OperationSmallKat/Luna-CAD/README.md

# Luna-CAD

Config file for CR6 should be placed in

```
$HOME/.local/share/cura-lulzbot/3.2/definition_changes/Creality+CR-6_settings.inst.cfg
```

derrived from https://community.ultimaker.com/topic/33852-creality-cr6-se/

and the .curaprofile imported through the GUI
