OperationSmallKat/Luna-CAD/Final Production Model/3D printing/Bed1Color1 (CR-6 SE).3mf

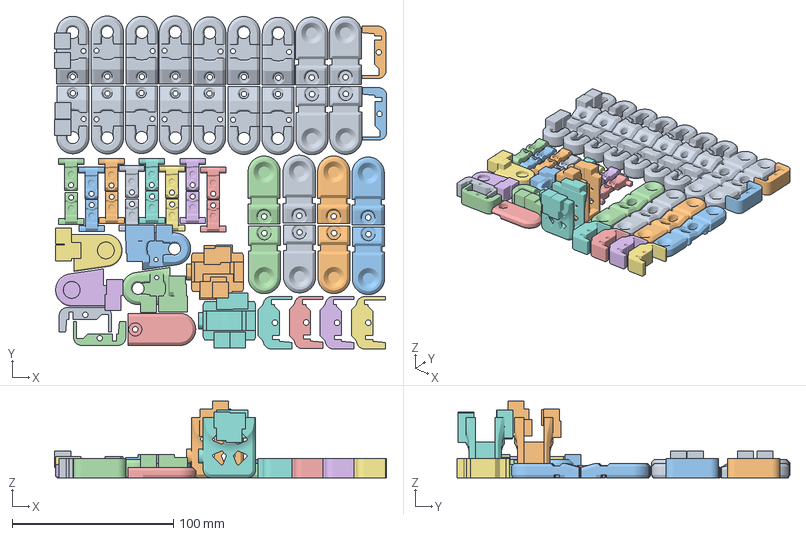
[picture p1: CAD file, 2021-01-08]
Final Production Model/3D printing/Bed1Color1 (CR-6 SE).3mf
206.0 x 206.4 x 47.5 mm
Group #4
Group #5
Group #6
Group #9
Servo Limb 4.stl
Group #8
Group #17
Shoulder Servo Cover.stl
Body Servo Cover.stl
Body Servo Cover.stl(1)
Body Servo Cover.stl(2)
Body Servo Cover.stl(3)
Shoulder Servo Cover.stl(1)
Shoulder Servo Cover.stl(2)
Shoulder Servo Cover.stl(3)
Group #18
Group #1
Group #19
Group #3
Group #16
Servo Limb 1 pt2.stl(8)
Servo Limb 1 pt2 (Mirror).stl
Servo Limb 1 pt2.stl(1)
Servo Limb 1 pt2 (Mirror).stl(2)
Servo Limb 1 pt2.stl(3)
Servo Limb 1 pt2.stl(4)
Servo Limb 1 pt2.stl(5)
Servo Limb 1 pt2 (Mirror).stl(6)
Servo Limb pt2 (Mirror).stl
Servo Limb pt2 (Mirror).stl(1)
Servo Limb pt2 (Mirror).stl(2)
Servo Limb pt2 (Mirror).stl(3)
Servo Limb pt2 (Mirror).stl(4)
Servo Limb pt2 (Mirror).stl(5)
Servo Limb pt2 (Mirror).stl(6)
Servo Limb pt2 (Mirror).stl(7)
