OperationSmallKat/Luna-CAD/Final Production Model/Body.stl

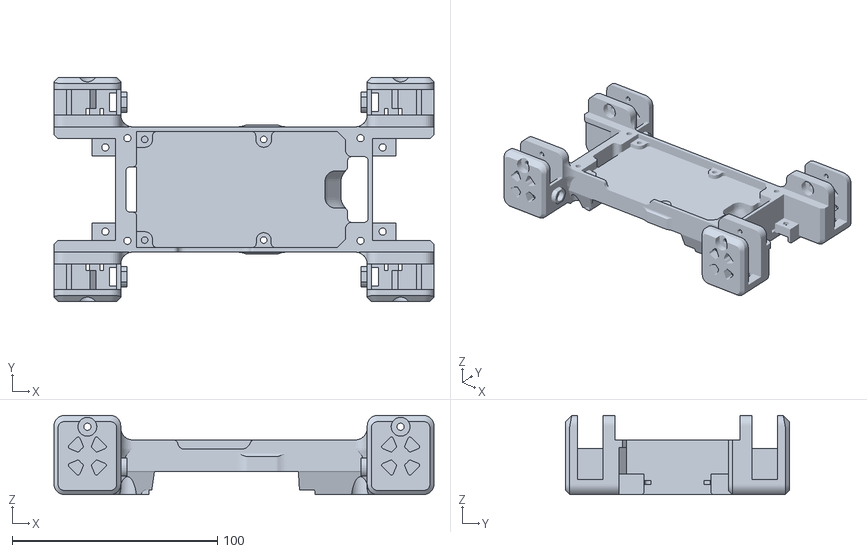
[picture p2: CAD file, 2021-04-23]
Final Production Model/Body.stl
185.0 x 109.0 x 38.5
