OperationSmallKat/Luna-CAD/Final Production Model/3D printing/Bed3Color2 (CR-6 SE).3mf

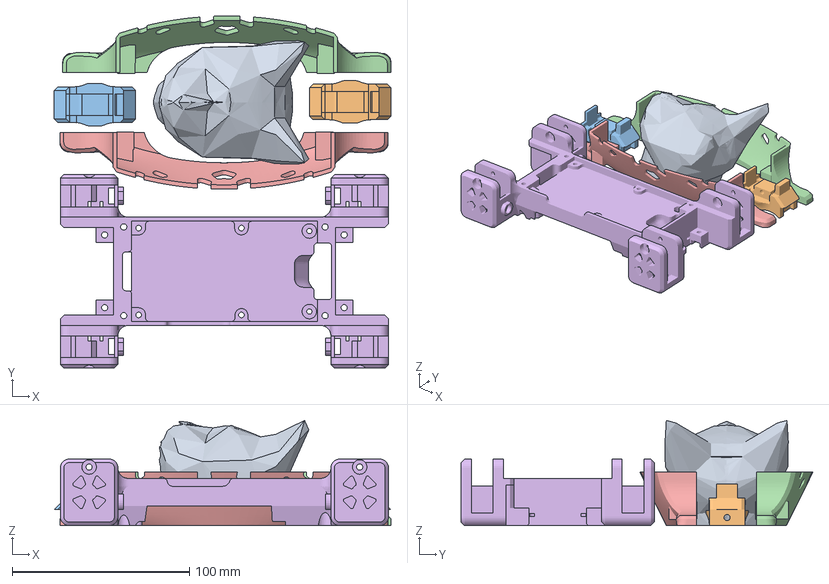
[picture p3: CAD file, 2021-01-08]
Final Production Model/3D printing/Bed3Color2 (CR-6 SE).3mf
189.9 x 198.4 x 59.3 mm
Head.stl
Knee Base.stl
Knee Base.stl(1)
Group #1
Group #2
Body.stl
