OperationSmallKat/Luna-CAD/Final Production Model/Foot-Joystick-Model.stl

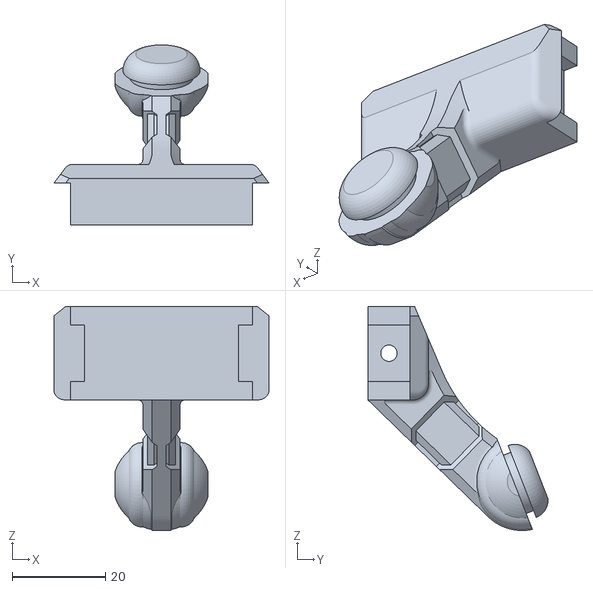
[picture p4: CAD file, 2021-02-12]
Final Production Model/Foot-Joystick-Model.stl
46.0 x 38.6 x 47.9
