OperationSmallKat/Luna-CAD/Final Production Model/Tests/Servo Limb 1 v7 pt2.stl

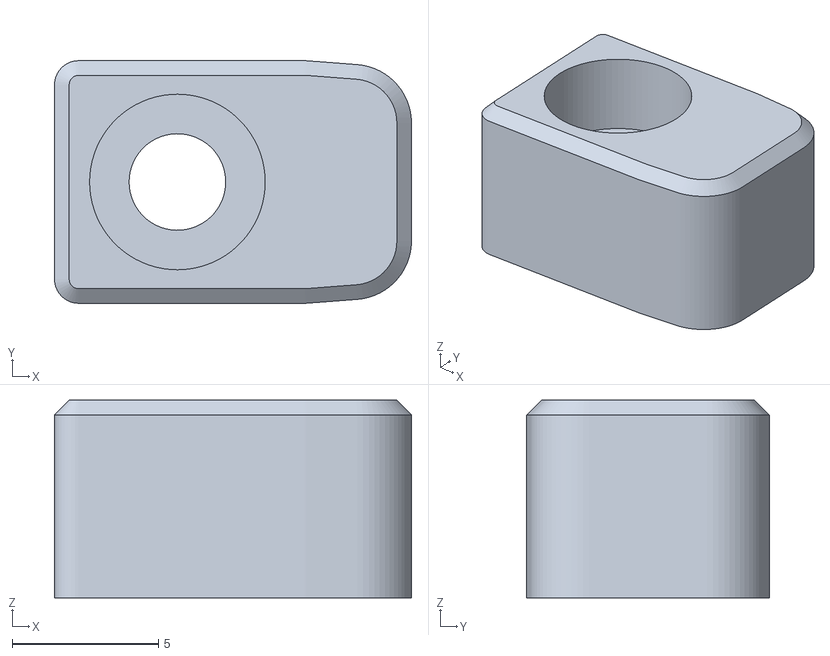
[picture p5: CAD file, 2021-02-20]
Final Production Model/Tests/Servo Limb 1 v7 pt2.stl
12.2 x 8.29 x 6.75
