OperationSmallKat/Luna-CAD/Final Production Model/Servo Limb pt2 (Mirror).stl

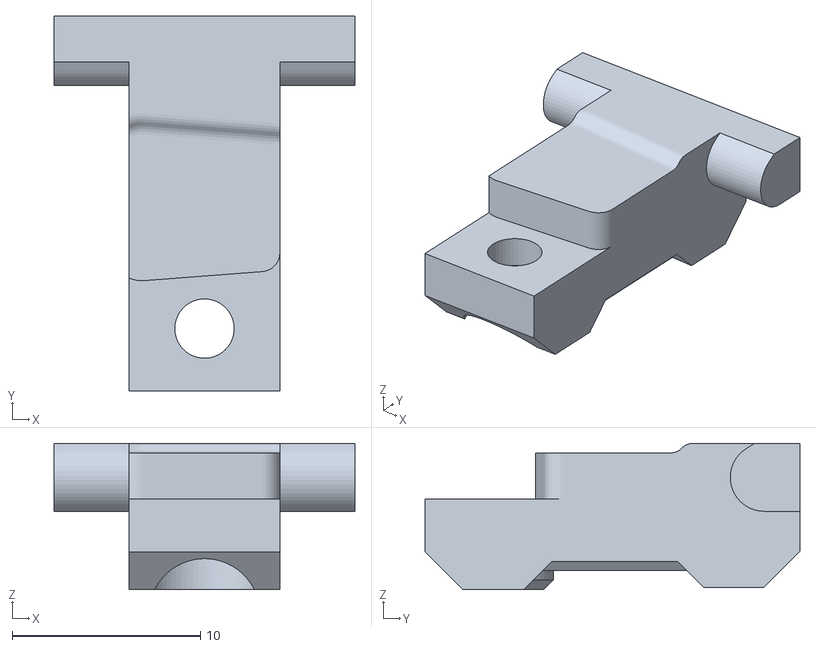
[picture p6: CAD file, 2021-01-08]
Final Production Model/Servo Limb pt2 (Mirror).stl
16.0 x 19.9 x 7.75
