OperationSmallKat/Luna-CAD/Final Production Model/Tests/Servo Limb 1 v7.stl

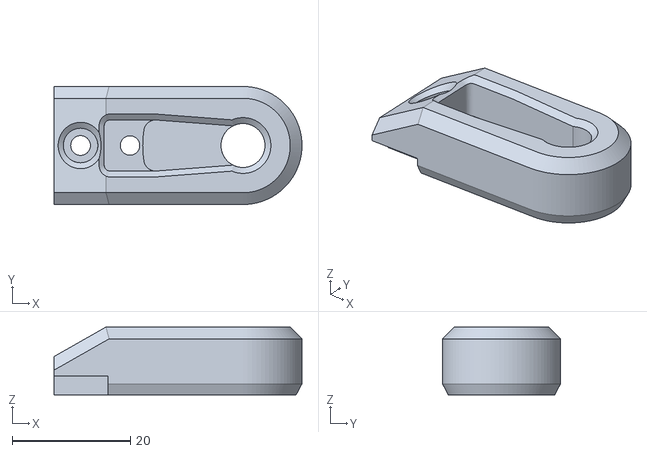
[picture p7: CAD file, 2021-02-20]
Final Production Model/Tests/Servo Limb 1 v7.stl
42.0 x 20.0 x 11.5
