OperationSmallKat/Luna-CAD/Final Production Model/3D printing/Bed2Color2 (CR-6 SE).3mf

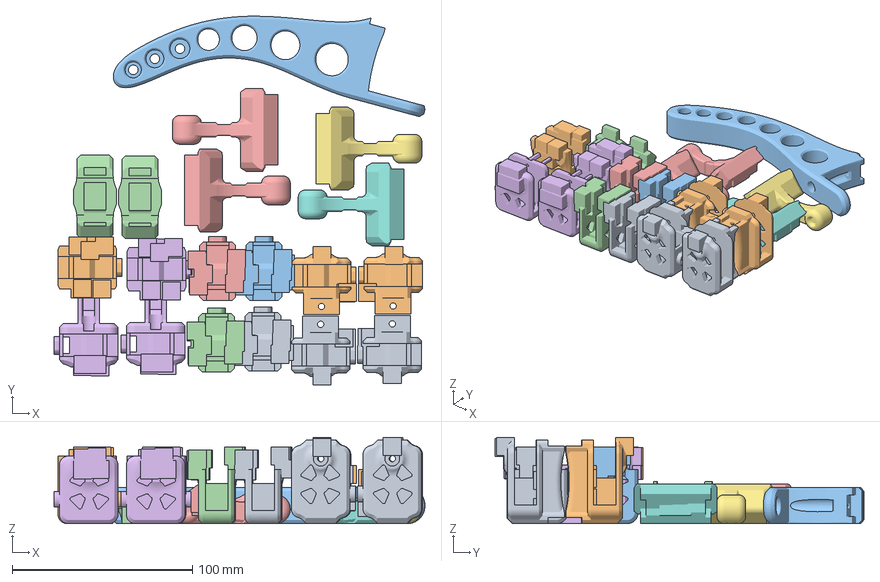
[picture p8: CAD file, 2020-12-29]
Final Production Model/3D printing/Bed2Color2 (CR-6 SE).3mf
205.8 x 204.5 x 47.8 mm
Group #6
Group #7
Group #8
Group #9
Group #10
Group #12
Foot.stl(3)
Foot.stl
Group #1
Group #2
Tail.stl
Group #4
Group #3
Group #5
