OperationSmallKat/Luna-CAD/Final Production Model/Calibration Jig.stl

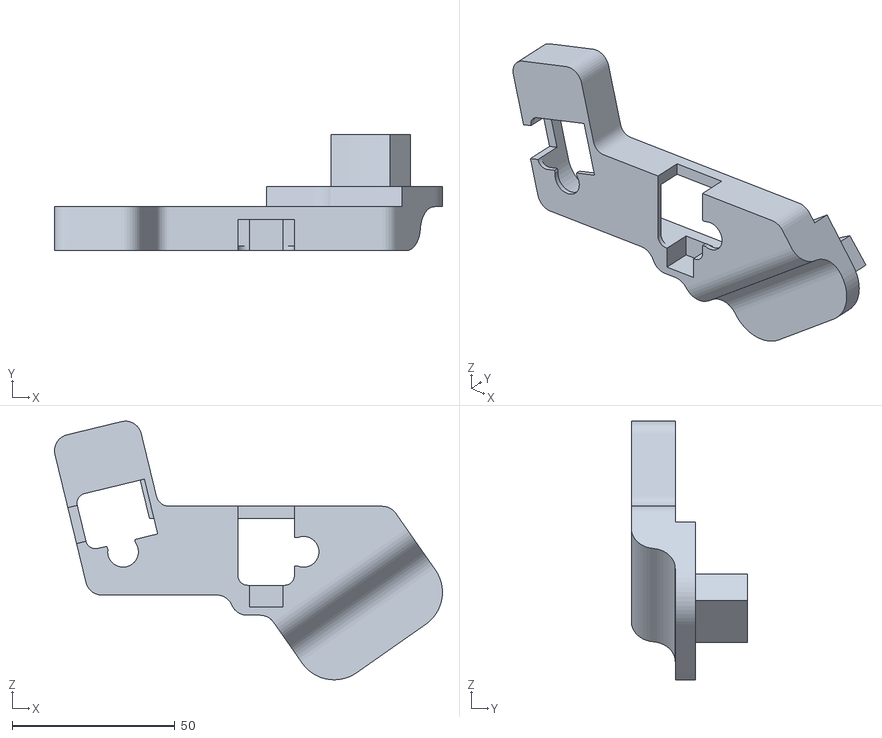
[picture p9: CAD file, 2021-01-03]
Final Production Model/Calibration Jig.stl
119.3 x 35.7 x 79.5
