OperationSmallKat/Luna-CAD/Final Production Model/Servo Limb 3.stl

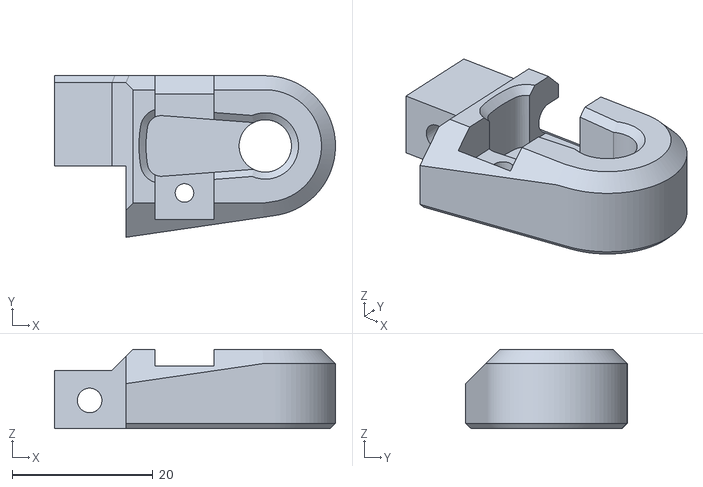
[picture p10: CAD file, 2020-12-31]
Final Production Model/Servo Limb 3.stl
40.0 x 23.0 x 11.2
