OperationSmallKat/Luna-CAD/Final Production Model/Servo Limb 1 - Small Horn.stl

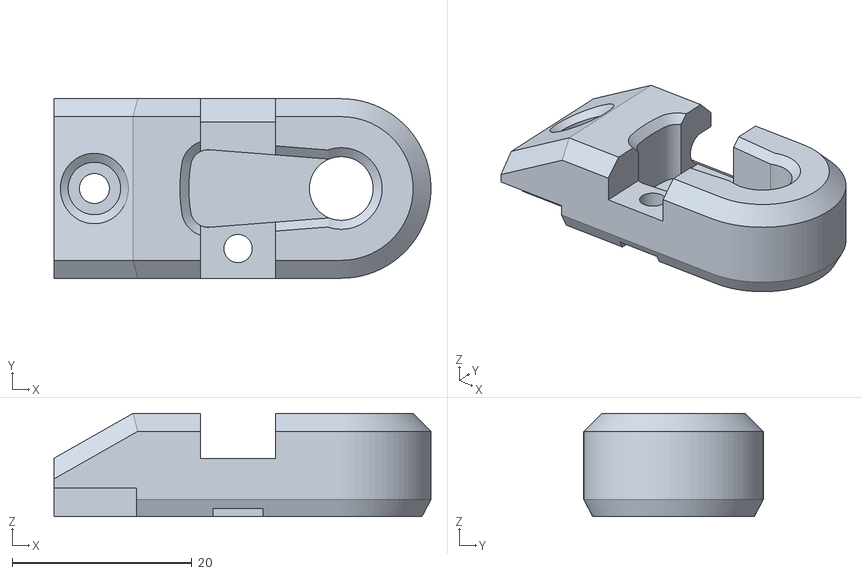
[picture p11: CAD file, 2020-12-27]
Final Production Model/Servo Limb 1 - Small Horn.stl
42.0 x 20.0 x 11.5
