OperationSmallKat/Luna-CAD/Final Production Model/Body Servo Cover.stl

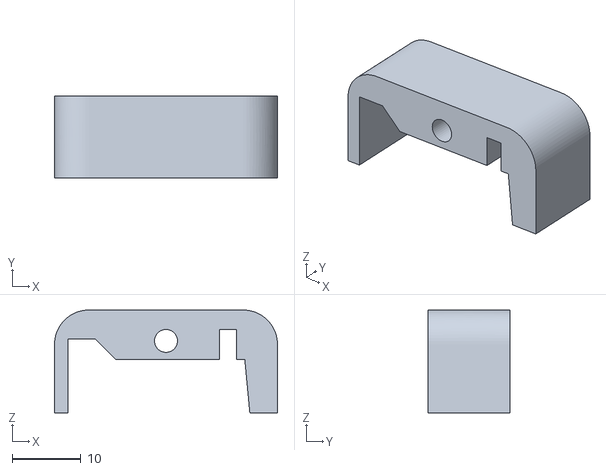
[picture p12: CAD file, 2020-12-19]
Final Production Model/Body Servo Cover.stl
32.5 x 12.0 x 15.0
