OperationSmallKat/Luna-CAD/Final Production Model/Shoulder Base (Mirror).stl

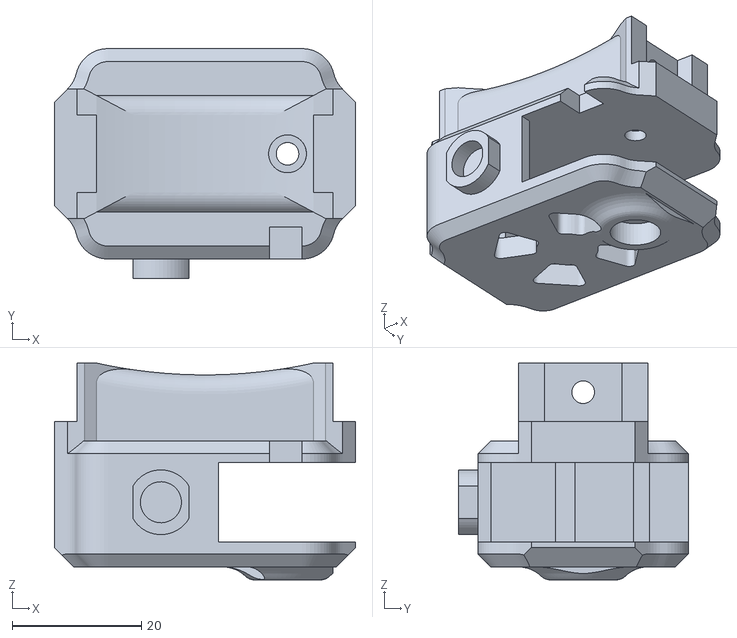
[picture p13: CAD file, 2020-12-19]
Final Production Model/Shoulder Base (Mirror).stl
46.5 x 35.5 x 33.5
