OperationSmallKat/Luna-CAD/Final Production Model/Servo Limb 5.stl

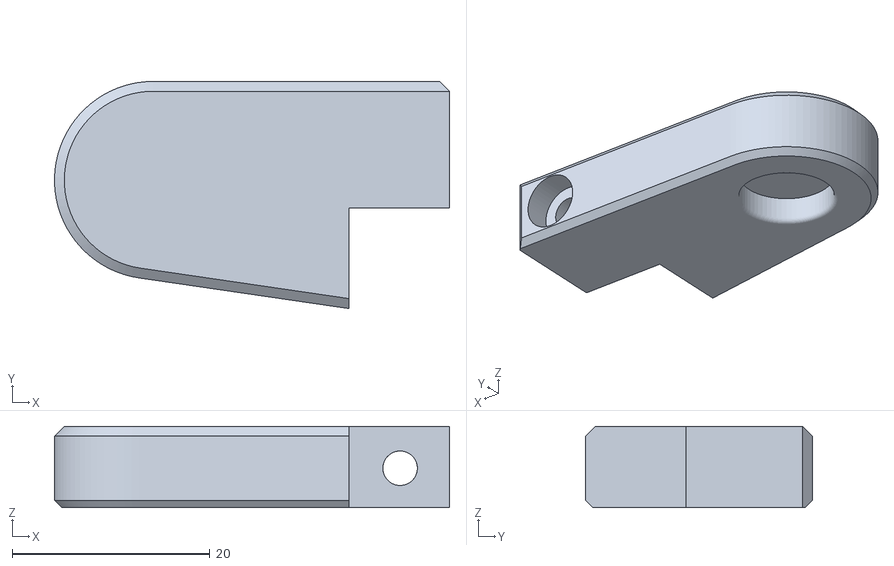
[picture p14: CAD file, 2020-12-19]
Final Production Model/Servo Limb 5.stl
40.0 x 23.0 x 8.25
