OperationSmallKat/Luna-CAD/Final Production Model/Head and Tail Base.stl

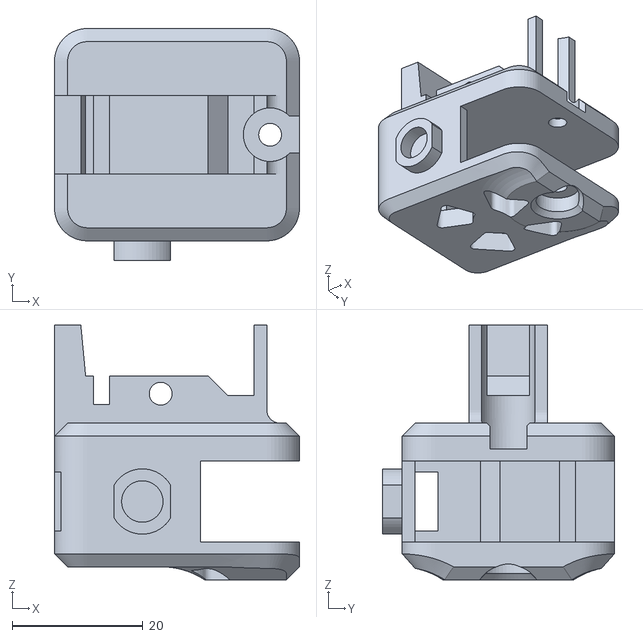
[picture p15: CAD file, 2020-12-19]
Final Production Model/Head and Tail Base.stl
37.5 x 35.5 x 39.0
