OperationSmallKat/Luna-CAD/Final Production Model/Head and Tail Servo Cover.stl

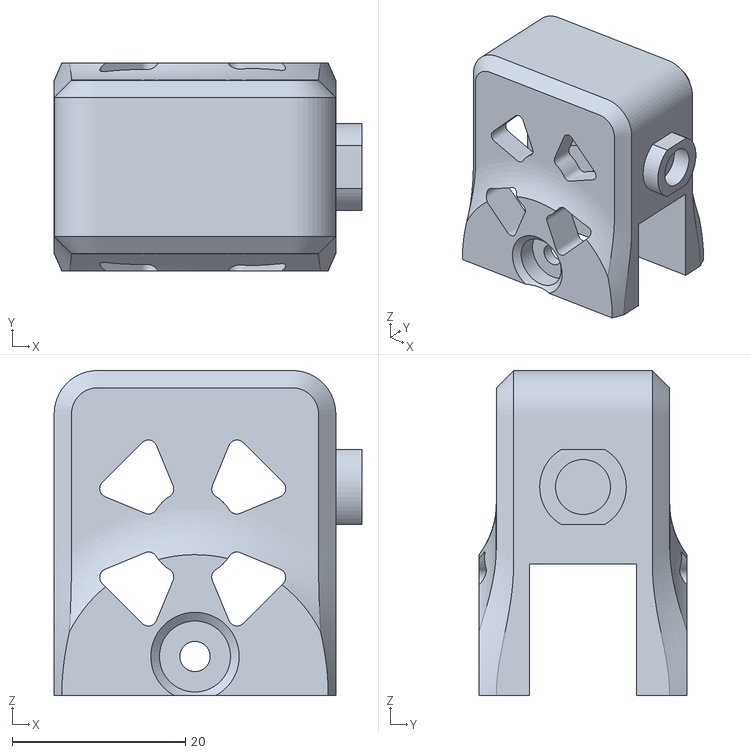
[picture p16: CAD file, 2020-12-19]
Final Production Model/Head and Tail Servo Cover.stl
35.5 x 24.0 x 37.5
