OperationSmallKat/Luna-CAD/Final Production Model/Shoulder Servo Cover.stl

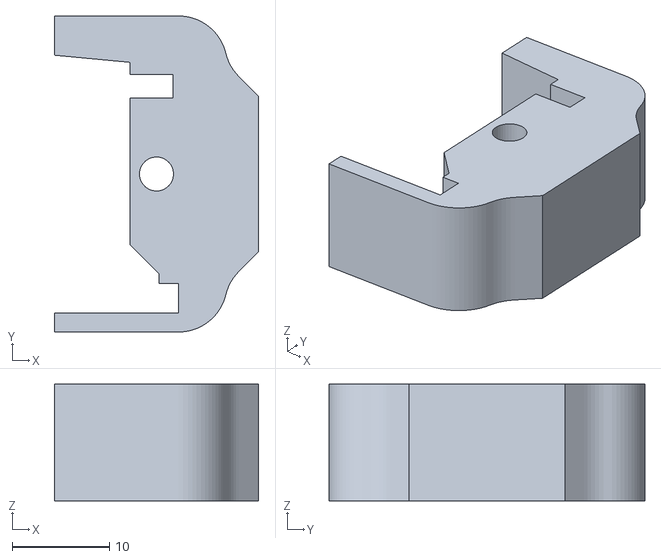
[picture p17: CAD file, 2020-12-19]
Final Production Model/Shoulder Servo Cover.stl
21.0 x 32.5 x 12.0
