OperationSmallKat/Luna-CAD/Final Production Model/Knee Top.stl

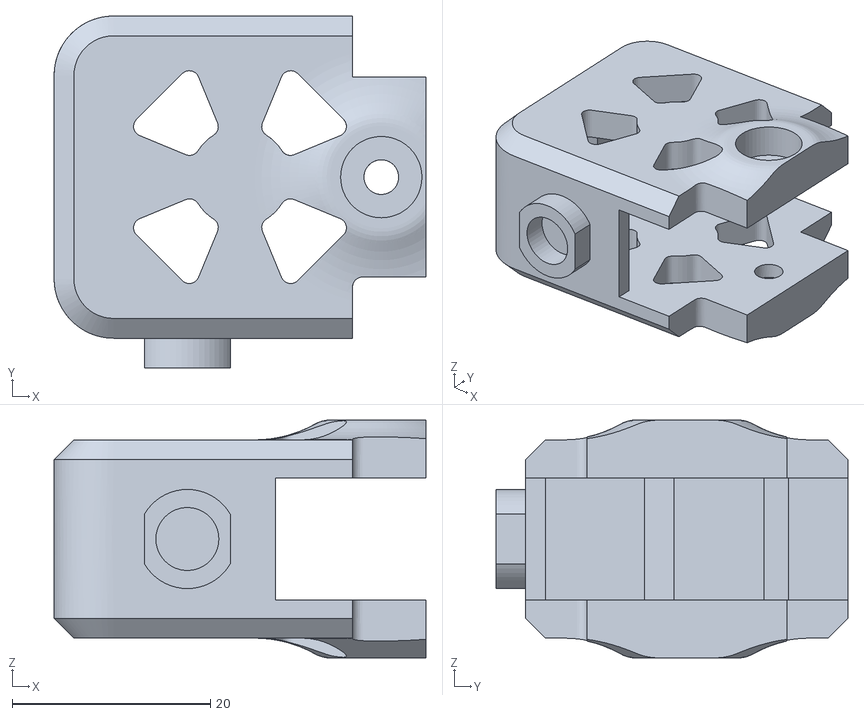
[picture p18: CAD file, 2020-12-19]
Final Production Model/Knee Top.stl
37.5 x 35.5 x 24.0
