OperationSmallKat/Luna-CAD/Final Production Model/Servo Limb 6 (Backup).stl

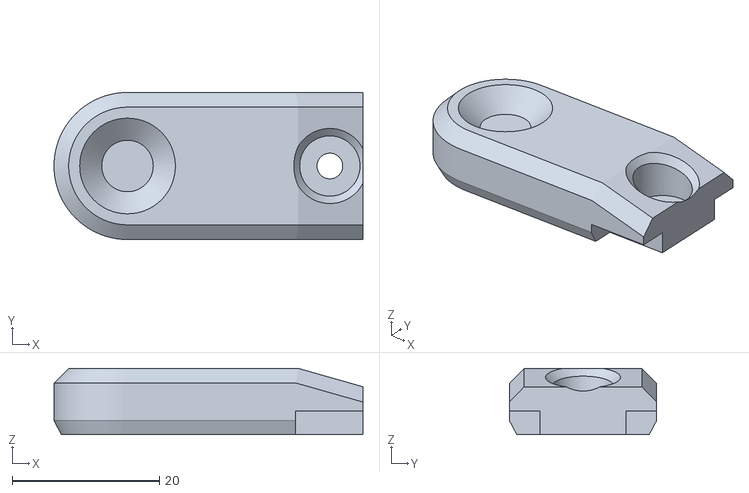
[picture p19: CAD file, 2020-12-19]
Final Production Model/Servo Limb 6 (Backup).stl
42.0 x 20.0 x 9.00
