OperationSmallKat/Luna-CAD/Final Production Model/Body Cover.stl

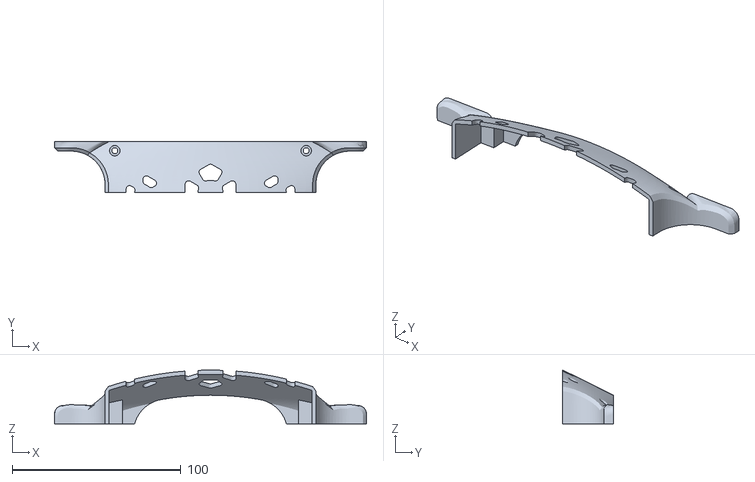
[picture p20: CAD file, 2020-12-19]
Final Production Model/Body Cover.stl
185.0 x 30.3 x 31.9
