OperationSmallKat/Luna-CAD/Final Production Model/Servo Limb 2.stl

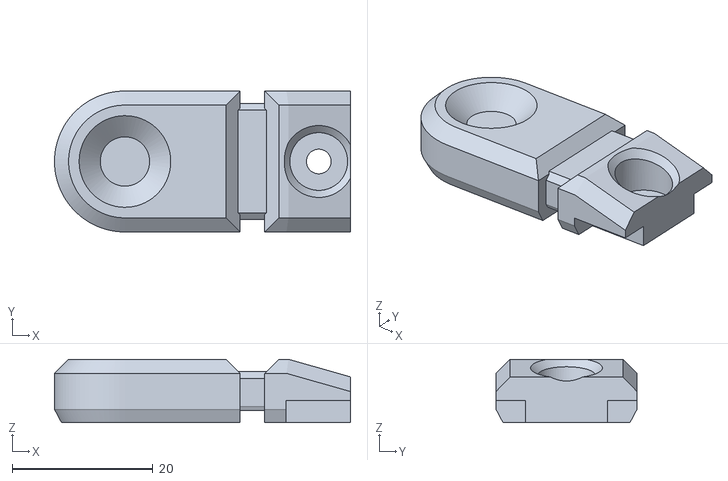
[picture p21: CAD file, 2020-12-19]
Final Production Model/Servo Limb 2.stl
42.0 x 20.0 x 9.00
