OperationSmallKat/Luna-CAD/Final Production Model/Servo Limb 4.stl

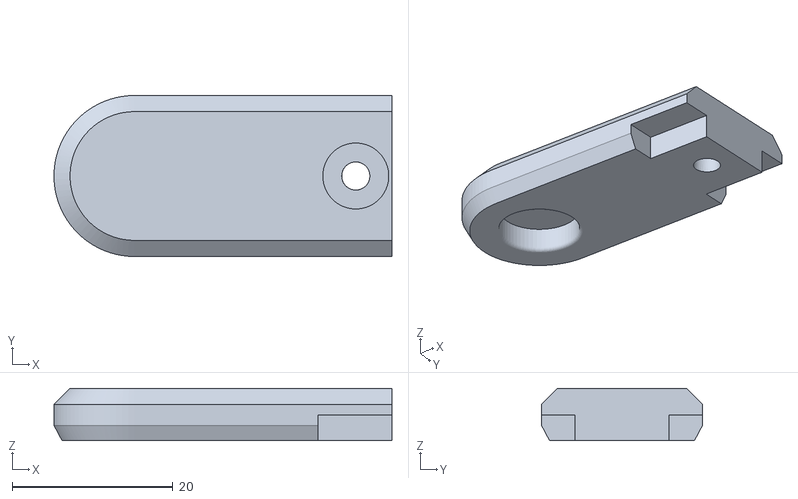
[picture p22: CAD file, 2020-12-19]
Final Production Model/Servo Limb 4.stl
42.0 x 20.0 x 6.50
