OperationSmallKat/Luna-CAD/Final Production Model/Head.stl

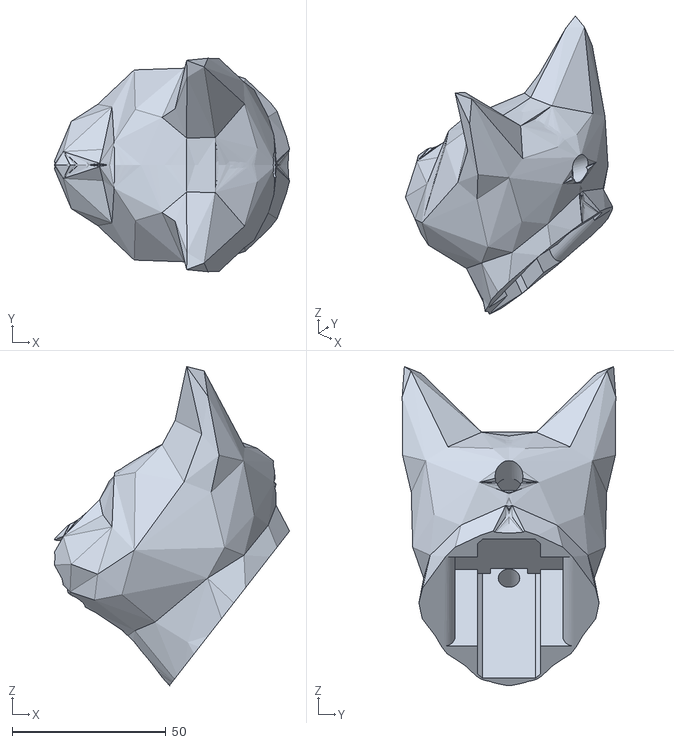
[picture p23: CAD file, 2020-12-19]
Final Production Model/Head.stl
76.5 x 69.4 x 103.7
