OperationSmallKat/Luna-CAD/Final Production Model/Knee Base.stl

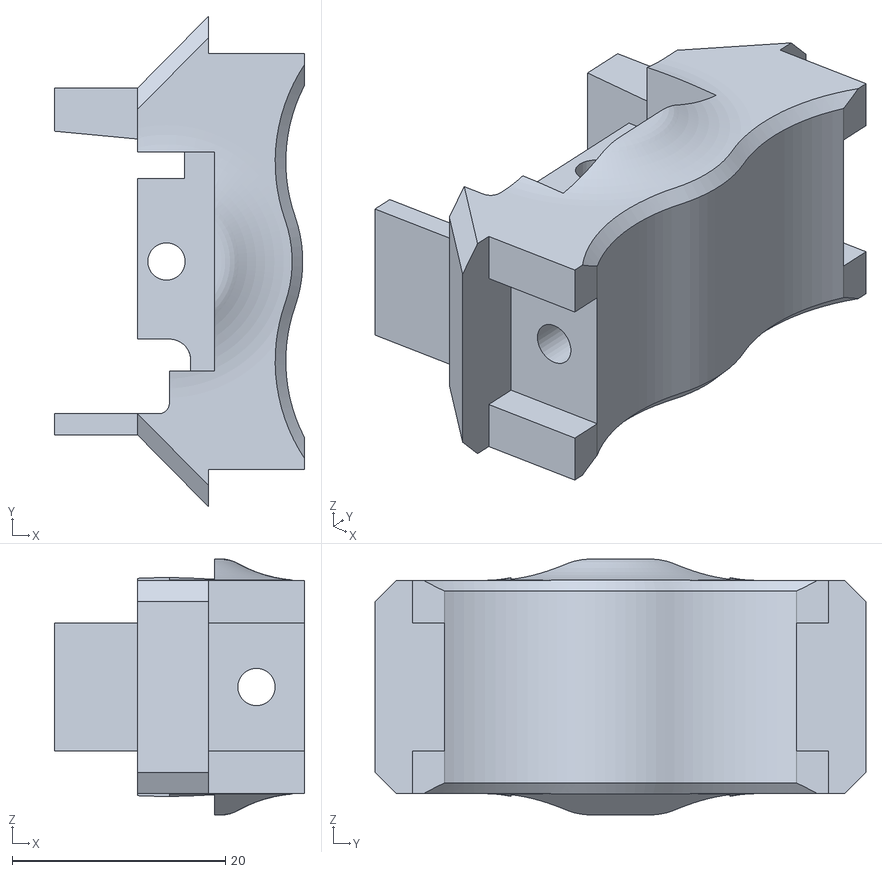
[picture p24: CAD file, 2020-12-19]
Final Production Model/Knee Base.stl
23.4 x 46.0 x 24.0
