OperationSmallKat/Luna-CAD/Final Production Model/Tail.stl

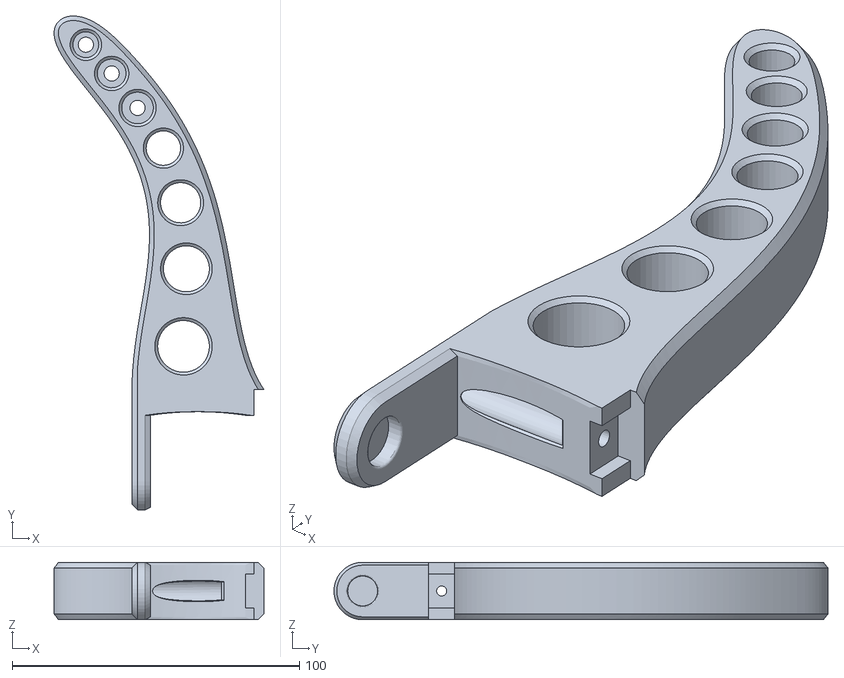
[picture p25: CAD file, 2020-12-19]
Final Production Model/Tail.stl
73.1 x 172.0 x 20.0
