OperationSmallKat/Luna-CAD/Final Production Model/Foot.stl

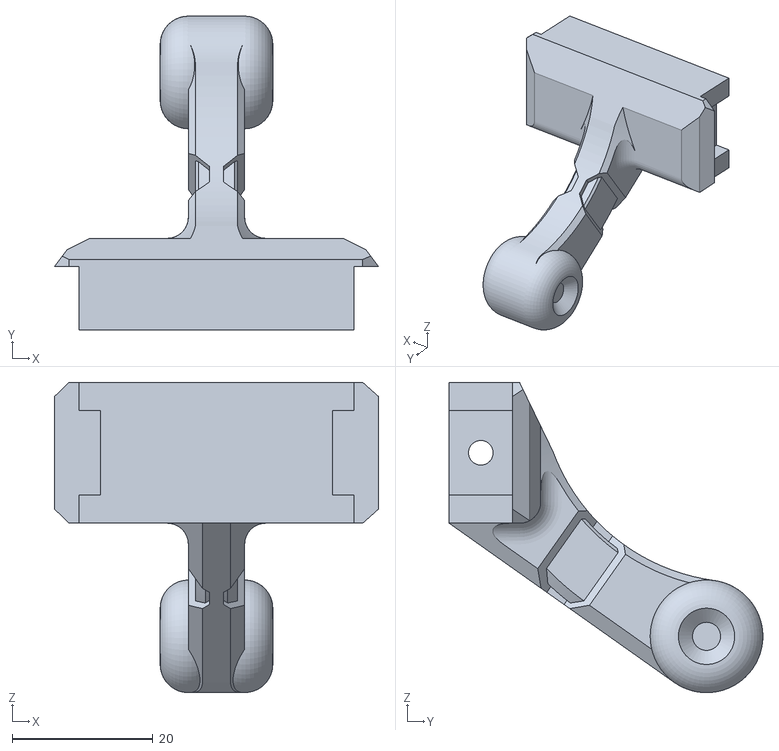
[picture p26: CAD file, 2020-12-15]
Final Production Model/Foot.stl
46.0 x 44.5 x 44.1
