OperationSmallKat/Luna-CAD/(list of files, cad)

Other CAD files:
Final Production Model/3D printing/Bed1Color1 (CR-6 SE) - Small Horn.3mf
Final Production Model/Servo Limb pt2.stl
Final Production Model/Calibration Jig Mirror.stl
Final Production Model/Servo Limb 3 - Small Horn.stl
Final Production Model/Servo Limb 1 (Mirror) - Small Horn.stl
Final Production Model/Servo Limb 1 (Mirror).stl
Final Production Model/Servo Limb 1.stl
Final Production Model/Shoulder Base.stl
Final Production Model/Tests/Servo Limb 1 v6 pt2.stl
Final Production Model/Tests/Servo Limb 1 v6.stl
