OperationSmallKat/Luna-CAD/(threads)

Thread 3 (2021-01-13):

recessed holes in the battery compartment need more clearence

madhephaestus, 2021-01-13:
the holes a printed onto support material and get clogged. they need more clearence around the head to avoid binding and have a deeper clearence so imperfections in the bottom of the hole do not prevent the head from recessing

Thread 4 (2021-01-13):

battery connector xt30 collides with the side of the body frame

madhephaestus, 2021-01-13:
it is a tight fit to get the battery board mounted, the xt 3o needs another 2mm clearence

Thread 6 (2021-01-13):

battery tab slots should be tapered so the battery can be pushed into place

madhephaestus, 2021-01-13:
if the tabs aren't held while inserting the battery, then the slots are destroyed by the tabs themselves.

Thread 7 (2021-01-13):

the battery tabs hold the battery too close to the bottom

madhephaestus, 2021-01-13:
there should be a clearence between the bottom of the battery and the bottom of the robot when fully inserted into the tabs. with any stray support material, malformed holes or not fully seated mother board mount bolt then the battery does not seat fully. Only the outer rim should seat fully, not the large flat bottom.

Thread 8 (2021-01-13):

Centered hinge for horns

madhephaestus, 2021-01-13:
The idea is to rotate the hinge so it lays across the entire horn. the mount screw should be at the tip of the horn, and the hinge near the rounded section of the horn

It may make sense to also change the geom of the cover from a plate with 2 little ears on the side, to something more like a spoon fitting into a single slot. This would let that part be printed sideways for much increased strength.

In addition to symmetrical, we can add a hole in the middle of the cover plate to be held down by the servo horn screw for added stability. then the hinge just needs to hold the friction while the horn screw is added on top.

madhephaestus, 2021-01-25:
after thinking about it, putting the bolt on the opposite side would be better. The highest force of the lever motion will be at the closest to the fulcrum of the lever. If the fulcrum is very close to the tip, then the forces on the tip would be much higher, and also consistent no matter where in the calibration sweep the tip is.

Thread 9 (2021-01-13):

Ball feet with thumbstick covers for grip

madhephaestus, 2021-01-13:
Change the feet from current form to a ball with a recessed scritoin for fitting thumbstick covers.

Here are the critical dimensions:

https://github.com/madhephaestus/SmallKatFootTest/blob/master/smallkatfeet.groovy#L6

Here is an STL of a working foot: https://github.com/madhephaestus/SmallKatFootTest/releases/download/0.0.1/0-.stl

Foot diameter = 20mm
Cap thickness = 2.25
Cap section diameter = 17.750
Distance from center of 2 balls to the lip of the recessed section= 4.475mm
Thickness of the tapered recess = 3.5mm

Closed 2021-02-12.

Thread 10 (2021-01-22):

Printbed is missing 2 u shaped covers for the neckand tail

madhephaestus, 2021-01-22:
there seems to be 4 for covering the tops of the servos in the body, but 2 are missing for the neck

Thread 12 (2021-01-25):

Ball-socket for head and tail

madhephaestus, 2021-01-25:
I'm having issues with the additional torque applied the the body as i move the tail up and down, vs left right. since both motors move its a lot of torque as it accelerates. Also i am having issues with the fact the axis do not intersect. What the mechanism from my animatronic eyes? both servos would be in the body, the head and tail would turn around the same axis for up down and left right, and the linkage clip-on acts asa  mechanical fuse for when it falls so the servos dont break. I measured it up, thers plenty of room to do it in the space provided

it would also make adding a small rubber band lug to help hold the tail up easier, something i think our poor little mg92b could use
