OperationSmallKat/Luna-CAD/(commit log)

2020-12-15 Foot.stl
    SmallKat Foot
    [Foot.stl]
2020-12-19 Most Updated Luna Models and gcode
    Most updated models with boards. Have yet to test the prints on new printer but will update modifications soon in nessacary
    [Bed1Color1 (CR-6 SE).3mf, Bed2Color2 (CR-6 SE).3mf, Bed3Color2 (CR-6 SE).3mf, Body Cover.stl, Body Servo Cover.stl, Body.stl, Head and Tail Base.stl, Head and Tail Servo Cover.stl]
2020-12-19 BOM/Updates to Files
    Removed unnescary files and modified names
    [Servo Limb 1 pt2.stl, Servo Limb pt2 (Mirror).stl, Servo Limb pt2.stl, Shoulder Base (Mirror).stl]
2020-12-27 Updated Print beds
    Added small servo horns pieces
    [Bed1Color1 (CR-6 SE) - Small Horn.3mf, Bed1Color1 (CR-6 SE).3mf, Servo Limb 1 (Mirror) - Small Horn.stl, Servo Limb 1 - Small Horn.stl, Servo Limb 3 - Small Horn.stl]
2020-12-29 Updated Bom
    Added weight breakdown and changes to 3d printing files
    [Bed2Color2 (CR-6 SE).3mf, Weight and Cost Breakdown.xlsx]
2020-12-31 Updated Servo Limb 3
    Fixed servo limb 3
    [Bed3Color2 (CR-6 SE).3mf, Servo Limb 3.stl]
2021-01-03 Calibration jig
    Made a jig. needs test print
    [Bed1Color1 (CR-6 SE).3mf, Calibration Jig Mirror.stl, Calibration Jig.stl]
2021-01-03 Fixed the calibration jig
    Needs print still
    [Calibration Jig Mirror.stl, Calibration Jig.stl]
2021-01-06 edited the servo thing
    3d printing, CAD and drinking, i have created a thing. behold its glorly. use the digital bits to create items of physical quality for they are what we hold dear and open up doors of possibilites we never thought possible. The smallest of Kats is born./ I give to the gift from my gray matter and hope that thee use it well and prosper with its shiny potenial
    [Servo Limb pt2.stl, Weight and Cost Breakdown.xlsx]
2021-01-08 updated printer files
    updated them files bruh
    [Bed1Color1 (CR-6 SE) - Small Horn.3mf, Bed1Color1 (CR-6 SE).3mf, Bed3Color2 (CR-6 SE).3mf, Body.stl, Servo Limb pt2 (Mirror).stl]
2021-02-20 test prints
    tests
    [Servo Limb 1 v6 pt2.stl, Servo Limb 1 v6.stl, Servo Limb 1 v7 pt2.stl, Servo Limb 1 v7.stl]
2021-04-23 updated body and print settings
    [Body.stl]
